xabifigu/EMG-Data-Logger/Documentation/capturas/osci vs pc/01_ch0_poti_from_csv.PNG

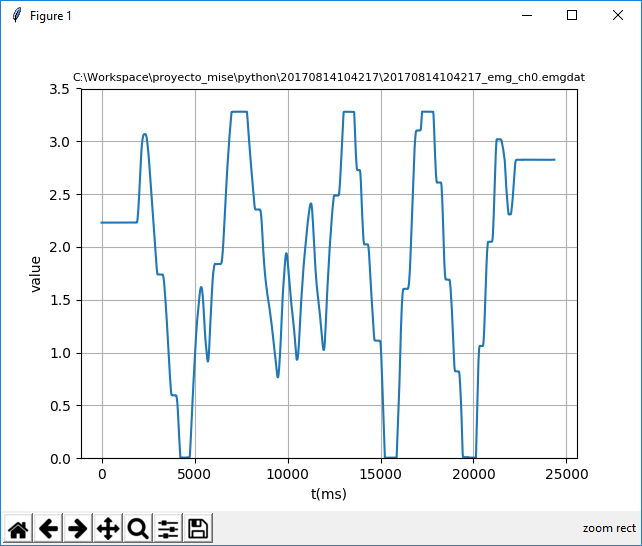
Documentation/capturas/osci vs pc/01_ch0_poti_from_csv.PNG
