xabifigu/EMG-Data-Logger/Documentation/capturas/osci vs pc/01_ch0_poti_osci.BMP

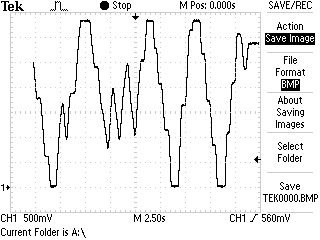
Documentation/capturas/osci vs pc/01_ch0_poti_osci.BMP
