xabifigu/EMG-Data-Logger/Documentation/capturas/osci vs pc/02_ch0_bicepsIz_from_csv.PNG

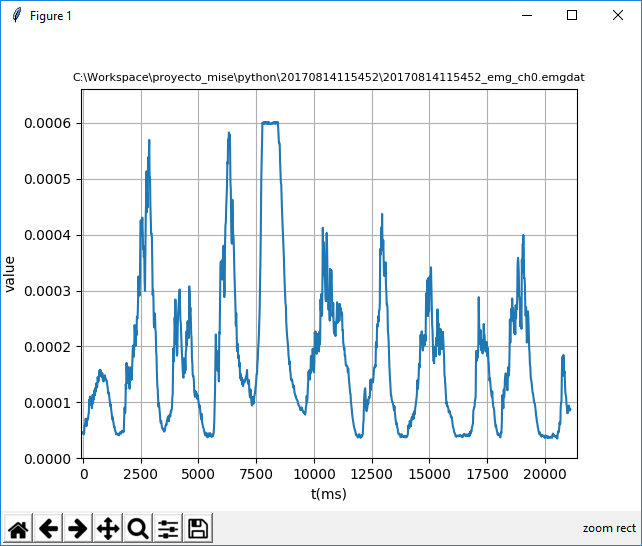
Documentation/capturas/osci vs pc/02_ch0_bicepsIz_from_csv.PNG
