xabifigu/EMG-Data-Logger/Documentation/capturas/osci vs pc/02_ch0_bicepsIz_osci.BMP

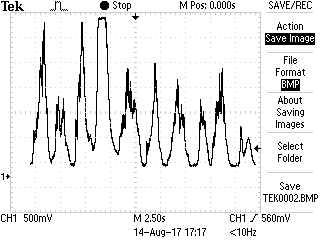
Documentation/capturas/osci vs pc/02_ch0_bicepsIz_osci.BMP
