xabifigu/EMG-Data-Logger/HW/tarjeta adaptada/EMG_expansion_board.sch

## KiCad design HW/tarjeta adaptada/EMG_expansion_board.sch (2017-08-24)


Parts:
D1: LED_VERDE
J1: FPGA_HEADER_2x13
J2: HC_05
J3, J4: GND_ROW
J5: 5V_ROW
J6: 3.3V_ROW
J7: ANALOG_INPUTS
R1: 100
R2, R3, R4, R5, R6, R7, R8, R9, R10: 10K
SW1: CH_IN_SELEC
SW9: RESET

Connections:
+3.3V: J1.1, J6.1, J6.2, J6.3, J6.4, SW9.1 (A)
+5V: J2.5, J5.1, J5.2, J5.3, J5.4
GND: J1.26, J2.4, J3.1, J3.2, J3.3, J3.4, J4.1, J4.2, J4.3, J4.4, R1.2, R2.2, R3.2, R4.2, R5.2, R6.2, R7.2, R8.2, R9.2, R10.2
unnamed: D1.1 (K), R1.1
unnamed: D1.2 (A), J1.5
unnamed: J1.2, R2.1, SW9.2 (B)
unnamed: J7.1, SW1.1
unnamed: J7.2, SW1.2
unnamed: J7.3, SW1.3
unnamed: J7.4, SW1.4
unnamed: J7.5, SW1.5
unnamed: J7.6, SW1.6
unnamed: J7.7, SW1.7
unnamed: J7.8, SW1.8
bit_tx: J1.7, J2.2
ch0_in: J1.24, R3.1, SW1.16
ch1_in: J1.25, R4.1, SW1.15
ch2_in: J1.22, R5.1, SW1.14
ch3_in: J1.21, R6.1, SW1.13
ch4_in: J1.23, R7.1, SW1.12
ch5_in: J1.18, R8.1, SW1.11
ch6_in: J1.19, R9.1, SW1.10
ch7_in: J1.20, R10.1, SW1.9
