xabifigu/EMG-Data-Logger/(commit log)

2017-06-18 ficheros ".m" creados velocidad uart bajada a 9600
2017-06-19 script de octave actualizado: función para encontrar cabecera implementada
2017-06-21 - todo en un mismo .m (no soy capaz de separarlo en varios) - se muestra un gráfico por cada canal
2017-06-21 - velocidad aumentada a 115200 (ir probando la estabilidad) - se exportan los datos a un csv, pero sin cabecera
2017-06-23 Corregidos pequeños bugs en serial_com.m; Primera aproximación para migrar el script a python
    [serial_com.py]
2017-06-24 script pyhton: se guardan los datos y el tiempo
2017-06-25 Script de octave portado a python
2017-06-28 bug smenores arreglados en script python
    [serial_com.py]
2017-07-08 cambiado el puerto para tcom por BL
2017-07-11 gitignore de altera actualizado
2017-07-12 implementación de gui empezada
2017-07-13 applicación actualizada: desde gui se puede elegir el puerto com, y al pulsar start comienza la recogida de datos
2017-07-13 actualización de nombres de variables
2017-07-19 documentos subidos
    [velocidadSerie.xlsx]
2017-07-22 módulo adc actualizado: código, testbench, diagrama y simulaciones
2017-07-23 simulacions correctas. módulos y memoria actualziados
    [main_block_tb.vhd, main_block_uc.vhd, main_block_uc_tb.vhd, uart_tx.vhd, uart_tx_tb.vhd, uart_tx_uc.vhd, uart_tx_uc_tb.vhd]
2017-07-25 proyectos de quartus de módulos independientes actualziados memoria actualizada
2017-07-25 actualización de la memoria
2017-08-05 commit del primer intento de mostrar el gráfico en tiempo real
2017-08-06 un canal en tiempo real funciona. Commit antes de intentar hacer que se muestren más canales en tiempo real
2017-08-08 ficheros para generar plots a partir de thread funcionan correctamente. Falta integraciçon de estos en GUI
    [serial_com.py]
2017-08-08 gráfica en tiempo real ahora sñi funciona para todos los canalaes
2017-08-08 primer approach para integrar tiempo real con gui
2017-08-08 intento de mostrar gráficas desde archivos
2017-08-09 - agregada función en emgPlot: csv2Plot. Esta función permite mostrar las gráficas a partir de todos los fichers '.emgdat' que existan en la ruta seleccionada. - la función 'csv2Plot' ha sido integra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
2017-08-09 gui actualizada: preparada para crear nueva ventana para mostrar la gráfica en tiempo real
2017-08-10 - se guardan los datos del número de canales especificado. - Se añaden protecciones de números incorrectos de canal en el gui
2017-08-11 actualizado el README
2017-08-11 gitignore de proyecto y README actualizados.
2017-08-12 gui actualizada para entrada de tensiones en lugar de puntos ADC
2017-08-13 memoria actualizada y pequeño bug en GUI corregido
    [emg_gui.py]
2017-08-13 error en GUI corregido: si no se detecta ningún puerto serie, no te inicializa el combobox asociado.
    [emg_gui.py]
2017-08-14 scripts python actualizados: se elimina Vmin (ahora siempre será 0), y se añade Rgain. Las gráficas se muestran en función de la ganancia, de esta manera, se muestra la tensión exacta medida en MyoWa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
2017-08-15 memoria actualizada. python: dependencia de librería PIL eliminada
2017-08-22 Gui y memoria actualizadas. Se ha añadido nueva constante en vhdl para poder comunicarse a 38400 baudios.
2017-08-24 memoria actualizada. Python corregido. esquema KiCad añadido
    [EMG_expansion_board.kicad_pcb, EMG_expansion_board.sch]
2017-08-29 script octave actualizado para que calcule el tiempo entre datos automáticamente. Memoria actualizada: commit antes de crear referencias
2017-08-31 se ha empezado a añadir los pies de foto y tablas
2017-09-01 pies de figuras y tablas actualizados
2017-09-02 pies de foto y tablas finalizado.
2017-09-03 actualización de anexo B de la memoria. Se ha copiado uart_tx.vhd de la carpeta Quartus a ModelSim. Se han modificado scripts de Python: - Comentarios añadidos - Al lanzar emg_gui.py se comprueba que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
2017-09-04 pequeña corrección en la memoria
